bbbenji/deciLight/misc/ESP32D-Pinout.jpg

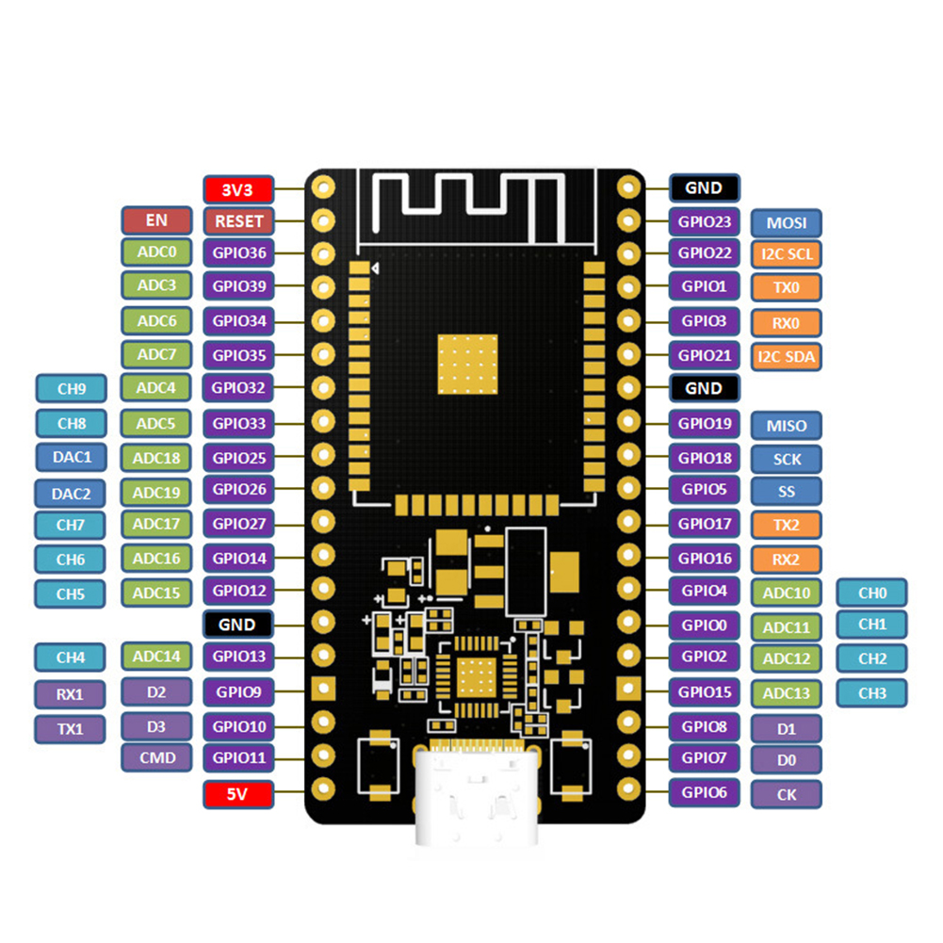
misc/ESP32D-Pinout.jpg
