bbbenji/deciLight/deciLight.ino

/*
 * deciLight - visual noise monitor
 *
 * A traffic-signal light that colours itself from the ambient sound level:
 * green while the room is below dB_min, yellow up to dB_max, red above it.
 * Thresholds, colours and brightness are set from an IR remote and survive a
 * power cycle.
 *
 * https://github.com/bbbenji/deciLight
 *
 * Sound level measurement is derived from esp32-i2s-slm by Ivan Kostoski
 * (c)2019, https://github.com/ikostoski/esp32-i2s-slm
 *
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
 * You should have received a copy of the GNU General Public License
 * along with this program.  If not, see <https://www.gnu.org/licenses/>.
 */

/*
 * Layout
 *
 *   config.h          every tunable value, no logic
 *   settings.*        thresholds and brightness, persisted to NVS
 *   sound_level.*     I2S sampling, IIR filtering, Leq in dB
 *   signal_light.*    LED state, colour mapping, smoothing and hysteresis
 *   remote_control.*  IR key map and what each key does
 *   display.*         optional SSD1306 status screen
 *   web_control.*     WiFi bring-up and the HTTP control interface
 *   group_sync.*      ESP-NOW level sharing between units
 *   web_page.h        the page served to the browser
 *   sos-iir-filter.h  filter kernel, upstream, do not include twice
 *
 * This file only wires them together.
 */

#include "config.h"
#include "display.h"
#include "group_sync.h"
#include "remote_control.h"
#include "settings.h"
#include "signal_light.h"
#include "sound_level.h"
#include "web_control.h"

// True once the microphone is running. When it is not, the remote still works
// so the light can be used as a plain lamp.
static bool micReady = false;

void setup() {
  // Drop the core clock before anything else starts depending on the timing.
  // FastLED drives the NeoPixels over RMT and I2S runs off the APLL, so both
  // are clocked independently of the CPU.
  setCpuFrequencyMhz(CPU_FREQ_MHZ);

  Serial.begin(SERIAL_BAUD);

  // Give the 5V rail a moment before the LEDs start drawing from it.
  delay(STARTUP_DELAY_MS);

  settings::begin();
  signal_light::begin(settings::get().brightness);
  signal_light::startBootEffect(4000);
  signal_light::tick();
  remote_control::begin();

  display::begin();
  display::setBrightness(settings::get().displayBrightness);
  display::splash();
  signal_light::tick();

  micReady = sound_level::begin();
  signal_light::tick();
  if (!micReady) {
    Serial.println(F("deciLight: no microphone, running in remote-only mode"));
    signal_light::setMode(signal_light::Mode::Off);
  }

  // Networking comes up last: it is the slowest step and the only optional
  // one, so everything else is already serving the room while it connects.
  if (web_control::begin()) {
    display::setStatus(web_control::address());
  } else {
    display::setStatus(FEATURE_WIFI ? "no wifi" : "");
  }

  // Needs the radio already up, so it follows web_control.
  group_sync::begin();

  const Settings& s = settings::get();
  signal_light::setZones(s.zones, s.inactiveLevel);

  Serial.printf("%s %s ready, thresholds %u - %u " DB_UNITS "\n", PRODUCT_NAME,
                FIRMWARE_VERSION, s.dbMin, s.dbMax);
}

void loop() {
  remote_control::poll();
  web_control::tick();
  group_sync::tick();
  signal_light::tick();
  display::tick();
  settings::tick();

  if (!micReady) {
    delay(LOOP_POLL_MS);
    return;
  }

  // Parks on the measurement queue for a short while, which paces the loop
  // without spinning and keeps worst-case remote latency at LOOP_POLL_MS.
  sound_level::Reading reading;
  if (!sound_level::read(reading, LOOP_POLL_MS)) return;

  if (SERIAL_LOG_LEVEL) {
    Serial.printf("%.1f " DB_UNITS "%s\n", reading.leqDb,
                  reading.quality == sound_level::Quality::Overload      ? " (overload)"
                  : reading.quality == sound_level::Quality::BelowNoiseFloor ? " (below noise floor)"
                                                                            : "");
  }

  // The address can change now that the unit retries its network, so this is
  // refreshed rather than captured once at boot.
  display::setStatus(web_control::address());

  web_control::publishLevel(reading);
  group_sync::publishLevel(reading.leqDb);

  const Settings& s = settings::get();

  // Raw levels go over the air and are combined raw; each unit then smooths
  // the result for itself, so a peer's smoothing never compounds with ours.
  const float level =
      s.groupLevel ? group_sync::groupLevel(reading.leqDb, s.combine) : reading.leqDb;

  signal_light::updateLevel(level, s.dbMin, s.dbMax);
  display::update(reading.leqDb, reading.quality, s, signal_light::mode(),
                  signal_light::zone());
}
