bbbenji/deciLight/ota.cpp

#include "ota.h"

#if FEATURE_WIFI && FEATURE_OTA

#include <Arduino.h>
#include <Update.h>
#include <WebServer.h>

#include "signal_light.h"

namespace ota {
namespace {

// Set at the start of an upload and read by the completion handler, which the
// web server calls separately once the body has been consumed.
bool authorized = false;
bool wrote = false;
bool started = false;  // whether the upload handler ran at all

bool passwordConfigured() { return OTA_PASSWORD[0] != '\0'; }

void handleUpload(WebServer& server) {
  HTTPUpload& upload = server.upload();

  switch (upload.status) {
    case UPLOAD_FILE_START: {
      authorized = false;
      wrote = false;
      started = true;

      if (!passwordConfigured()) {
        Serial.println(F("ota: refused, no OTA_PASSWORD is set"));
        return;
      }
      // Checked on the first chunk rather than in the completion handler, so
      // an unauthenticated client cannot stream a whole firmware image at us
      // before being turned away.
      if (!server.authenticate(OTA_USERNAME, OTA_PASSWORD)) {
        // Distinguishing these two saves a lot of guessing: a missing header
        // is a client that never sent credentials, a present one that fails
        // is genuinely the wrong username or password.
        Serial.println(server.hasHeader("Authorization")
                           ? F("ota: refused, wrong username or password")
                           : F("ota: refused, no Authorization header was sent"));
        return;
      }
      authorized = true;

      Serial.printf("ota: receiving %s\n", upload.filename.c_str());
      // Display dynamic Gemini AI rainbow swirl animation for the duration.
      signal_light::setUpdatingEffect(true);
      signal_light::tick();

      if (!Update.begin(UPDATE_SIZE_UNKNOWN)) {
        Update.printError(Serial);
        authorized = false;
        signal_light::setUpdatingEffect(false);
      }
      break;
    }

    case UPLOAD_FILE_WRITE:
      if (!authorized) return;
      if (Update.write(upload.buf, upload.currentSize) != upload.currentSize) {
        Update.printError(Serial);
        authorized = false;
        signal_light::setUpdatingEffect(false);
        return;
      }
      wrote = true;
      signal_light::tick();
      break;

    case UPLOAD_FILE_END:
      if (!authorized) {
        signal_light::setUpdatingEffect(false);
        return;
      }
      // true finalises and marks the new image bootable.
      if (Update.end(true)) {
        Serial.printf("ota: wrote %u bytes, restarting\n", upload.totalSize);
        // Keep updating effect active right until reboot
        signal_light::tick();
      } else {
        Update.printError(Serial);
        authorized = false;
        signal_light::setUpdatingEffect(false);
      }
      break;

    case UPLOAD_FILE_ABORTED:
      Serial.println(F("ota: upload aborted"));
      Update.abort();
      authorized = false;
      signal_light::setUpdatingEffect(false);
      signal_light::tick();
      break;

    default:
      break;
  }
}

void handleResult(WebServer& server) {
  if (!passwordConfigured()) {
    server.send(503, "application/json",
                "{\"error\":\"OTA is disabled until OTA_PASSWORD is set\"}");
    return;
  }
  if (!started) {
    server.send(400, "application/json", "{\"error\":\"no firmware was uploaded\"}");
    return;
  }
  if (!authorized) {
    // Advertise the challenge, so a client that did not send credentials
    // preemptively - curl without -u, or a plain browser navigation - is told
    // how to, instead of just being turned away.
    server.sendHeader("WWW-Authenticate", "Basic realm=\"deciLight\"");
    server.send(401, "application/json", "{\"error\":\"unauthorized\"}");
    return;
  }
  if (!wrote || Update.hasError()) {
    signal_light::setUpdatingEffect(false);
    signal_light::setManualColor(COLOR_FAILED);
    signal_light::tick();
    server.send(400, "application/json", "{\"error\":\"update failed\"}");
    return;
  }

  server.send(200, "application/json", "{\"ok\":true,\"restarting\":true}");
  server.client().flush();
  for (int i = 0; i < 10; i++) {
    signal_light::tick();
    delay(20);
  }
  ESP.restart();
}

}  // namespace

bool available() { return passwordConfigured(); }

const char* username() { return OTA_USERNAME; }

bool registerRoutes(WebServer& server) {
  // Same reset contract as the other modules' begin(). These are also
  // cleared at the start of every upload, but leaving them stale here would
  // mean a completion handler could answer for an upload that never ran.
  authorized = false;
  wrote = false;
  started = false;

  server.on(
      "/api/update", HTTP_POST,
      [&server]() { handleResult(server); },
      [&server]() { handleUpload(server); });

  if (!passwordConfigured()) {
    Serial.println(F("ota: disabled, set OTA_PASSWORD in config.h to enable"));
    return false;
  }
  Serial.println(F("ota: update endpoint ready at /api/update"));
  return true;
}

}  // namespace ota

#endif  // FEATURE_WIFI && FEATURE_OTA
