bbbenji/deciLight/(commit log)

2026-08-18 feat: implement internal web control interface and WiFi configuration support
    [partitions.csv]
2026-08-18 refactor: pin FastLED to 3.9.20 to optimize flash size and remove custom partition table dependency
    [partitions.csv]
2026-08-18 docs: add detailed wiring documentation and update pin mapping configuration
2026-08-18 feat: implement preemptive Basic Auth for OTA updates and improve credential error handling
    [config.h, ota.cpp, ota.h, web_control.cpp]
2026-08-18 feat: implement IR remote diagnostic tracking and a self-test LED sequence
2026-08-18 feat: add adjustable screen brightness with power-saving mode and web UI controls
2026-08-18 refactor: ensure module begin() functions reset all internal state to avoid stale data and update firmware version to 1.0.6
    [config.h, fakes.cpp, ota.cpp, remote_control.cpp, settings.cpp, sound_level.cpp, test_remote_control.cpp, test_settings.cpp]
2026-08-18 feat: add ESP-NOW - zone filtering, group level synchronization, and configurable alarm combining to settings and signal logic
2026-09-14 docs: add ESP32 wiring diagram SVG and update documentation
